strjonas/tischlein/out/actuators.png

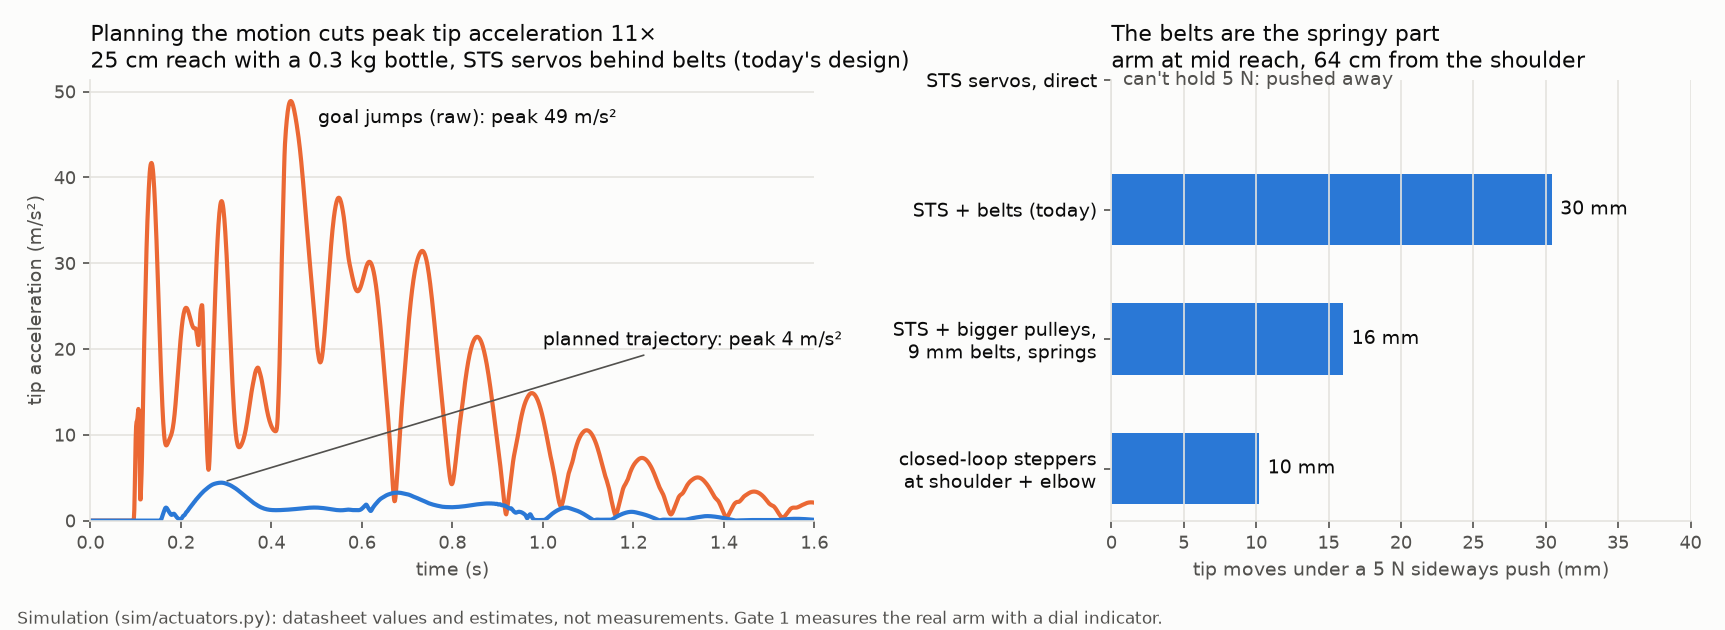
out/actuators.png
