strjonas/tischlein/out/demo_strip.png

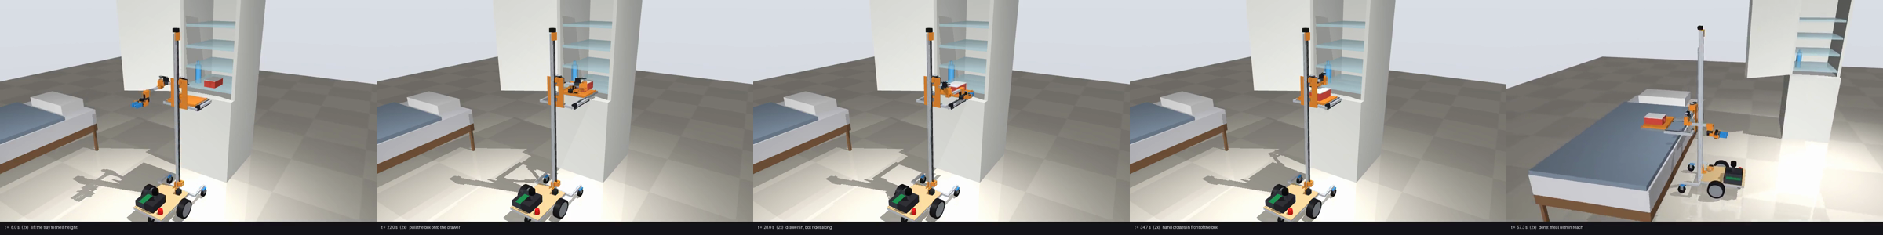
out/demo_strip.png
