strjonas/tischlein/out/heights.png

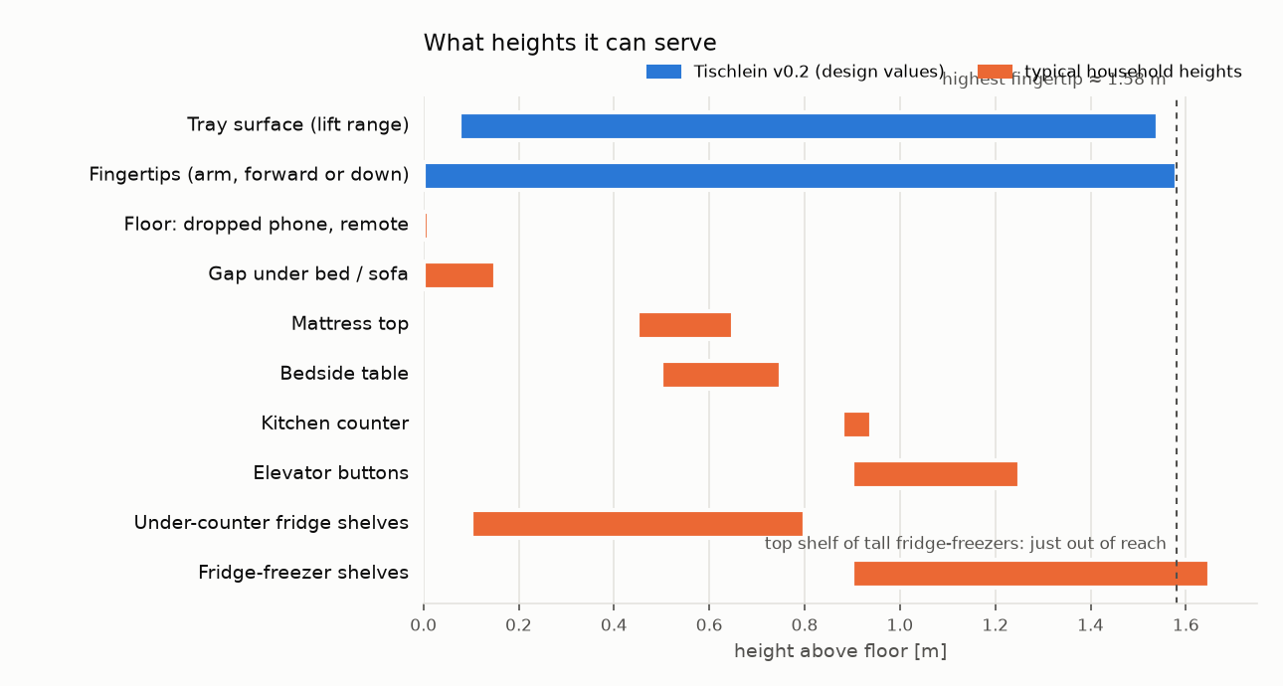
out/heights.png
