strjonas/tischlein/designs/breakfast-cell/build11/print/pin_microwave.stl

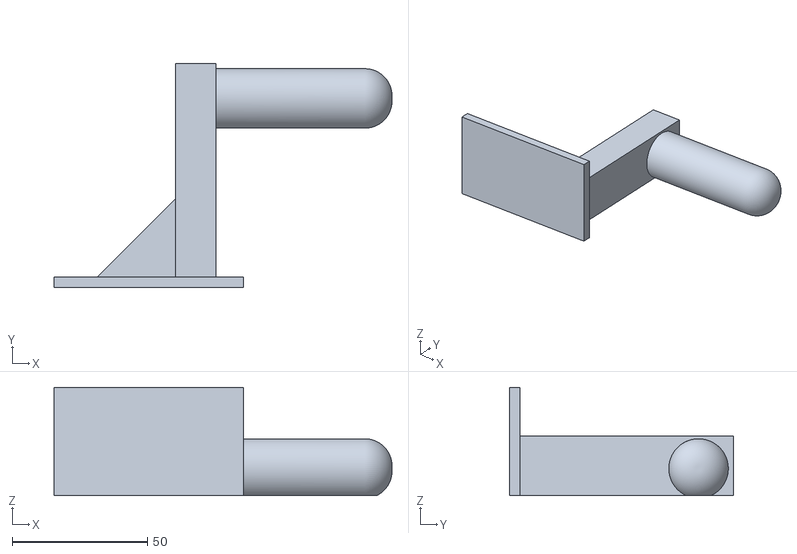
[picture p13: CAD file, 2026-11-09]
designs/breakfast-cell/build11/print/pin_microwave.stl
125.0 x 83.0 x 40.0
