strjonas/tischlein/out/tischlein_v0_2.step

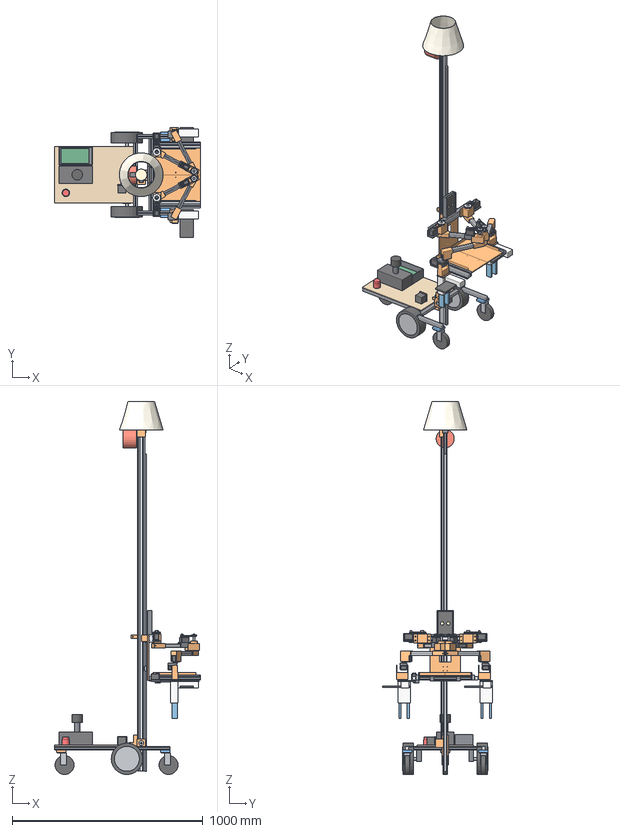
[picture p14: CAD file, 2026-11-09]
out/tischlein_v0_2.step
766.0 x 578.9 x 1954.6 mm
frame_side x 2
frame_cross
frame_cross_front
straddle_leg_2020 x 2
deck_plywood
hub_motor x 2
hub_motor_hub x 2
axle x 2
axle_clamp_adapter x 2
caster_wheel x 3
caster_fork x 3
front_caster_pad_tpu x 2
rear_caster_spring_mount
battery_hoverboard_36v
electronics_box
pi_and_drivers
estop
lidar_post
lidar_rplidar_c1
mast_2040
rail_mgn12
mast_foot_gusset x 2
nema17
nema17_mount
lift_pulley_20T
lift_reduction_60T
motor_pulley_20T
lift_lower_bearing_block
lift_top_idler
lift_top_block
lift_belt x 2
lamp_holder
lamp_led_disk
lamp_shade
balancer_hanger
spring_balancer_3_5kg
carriage_plate
mgn12h_block x 2
yoke_2020
tray_arm_2020 x 2
slide_250_outer x 2
slide_spacer x 2
yoke_bracket
servo_J5_roll x 10
pulley_20T_drawer
idler_drawer
belt_drawer
drawer_servo_mount
shoulder_beam_2040
shoulder_housing
bearing_6000 x 8
j1_servo_bracket
pulley_20T_J1 x 2
belt_J1_200 x 2
shoulder_housing_b
servo_J1
j1_servo_bracket_b
face_mount
face_phone
face_eye x 2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
