strjonas/tischlein/print/j1_servo_bracket_b.stl

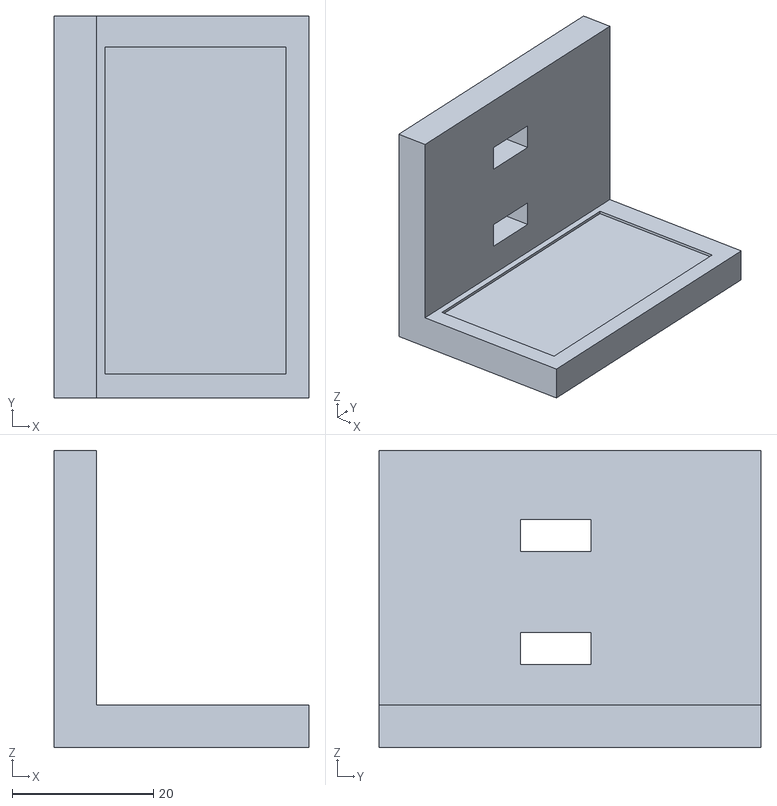
[picture p15: CAD file, 2026-11-09]
print/j1_servo_bracket_b.stl
36.0 x 54.0 x 42.0
