strjonas/tischlein/designs/breakfast-cell/build11/print/fit_gauge.stl

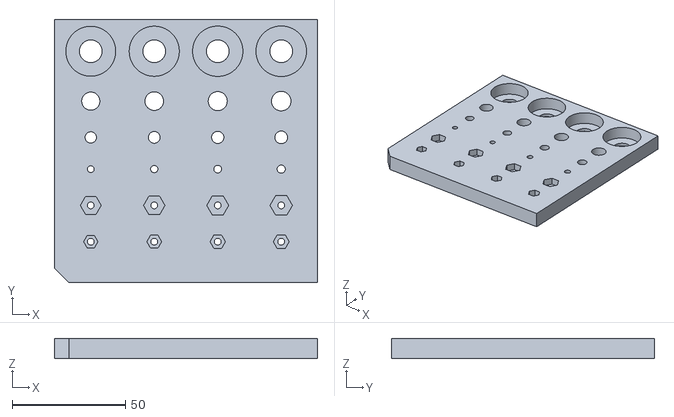
[picture p16: CAD file, 2026-11-09]
designs/breakfast-cell/build11/print/fit_gauge.stl
116.0 x 116.0 x 9.00
