strjonas/tischlein/designs/breakfast-cell/build11/print/slot_keys.stl

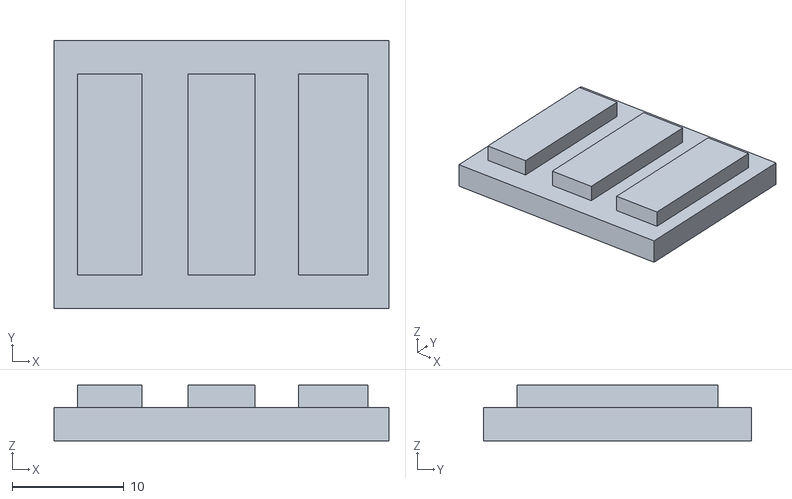
[picture p17: CAD file, 2026-11-09]
designs/breakfast-cell/build11/print/slot_keys.stl
30.0 x 24.0 x 5.00
