strjonas/tischlein/print/wrist_bracket.stl

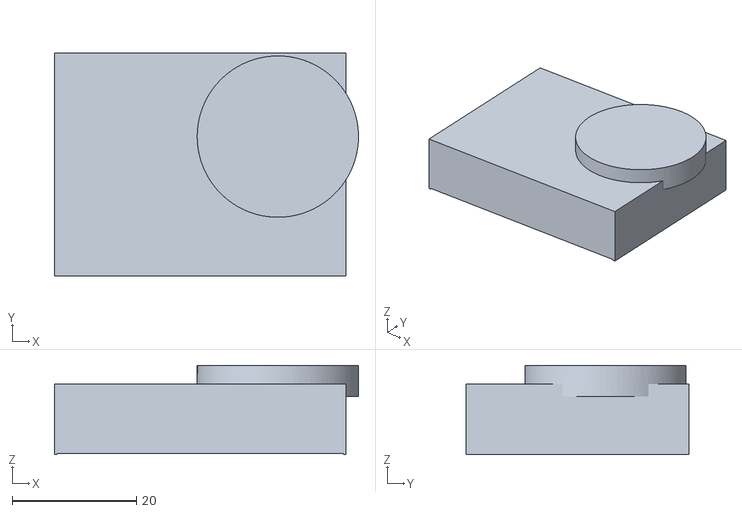
[picture p18: CAD file, 2026-11-09]
print/wrist_bracket.stl
49.0 x 36.0 x 14.4
