strjonas/tischlein/designs/breakfast-cell/build11/print/pin_fridge.stl

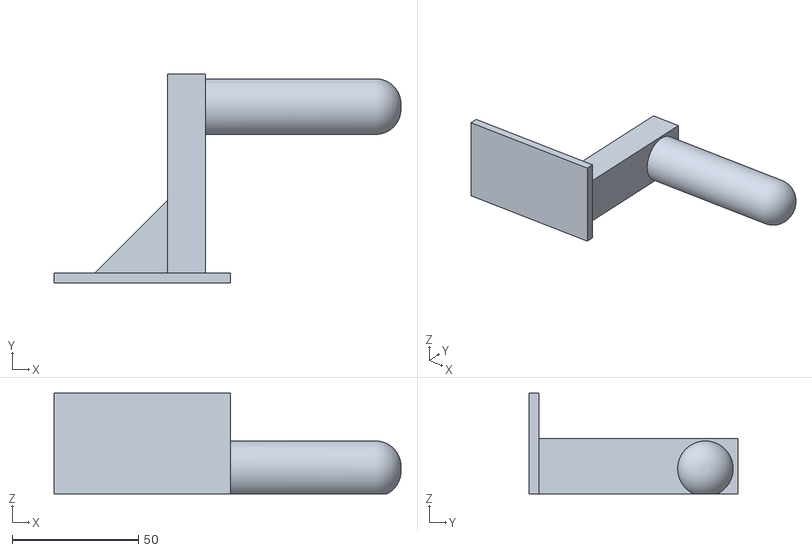
[picture p19: CAD file, 2026-11-09]
designs/breakfast-cell/build11/print/pin_fridge.stl
137.5 x 83.0 x 40.0
