strjonas/tischlein/print/l2_root_clamp.stl

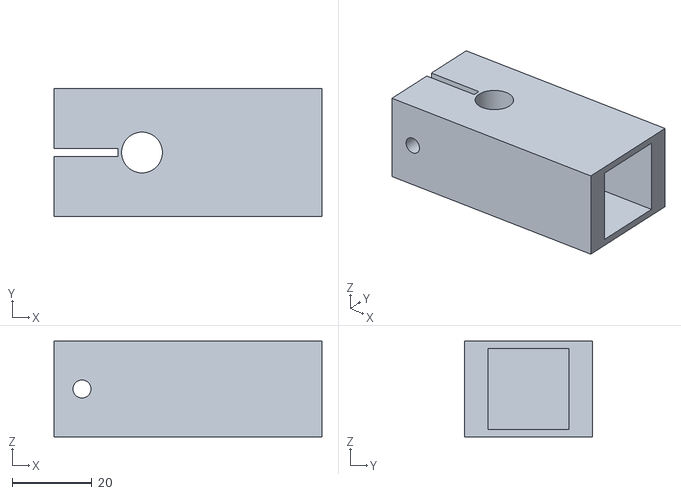
[picture p20: CAD file, 2026-11-09]
print/l2_root_clamp.stl
67.0 x 32.0 x 24.0
