strjonas/tischlein/designs/breakfast-cell/build11/print/servo_frames.stl

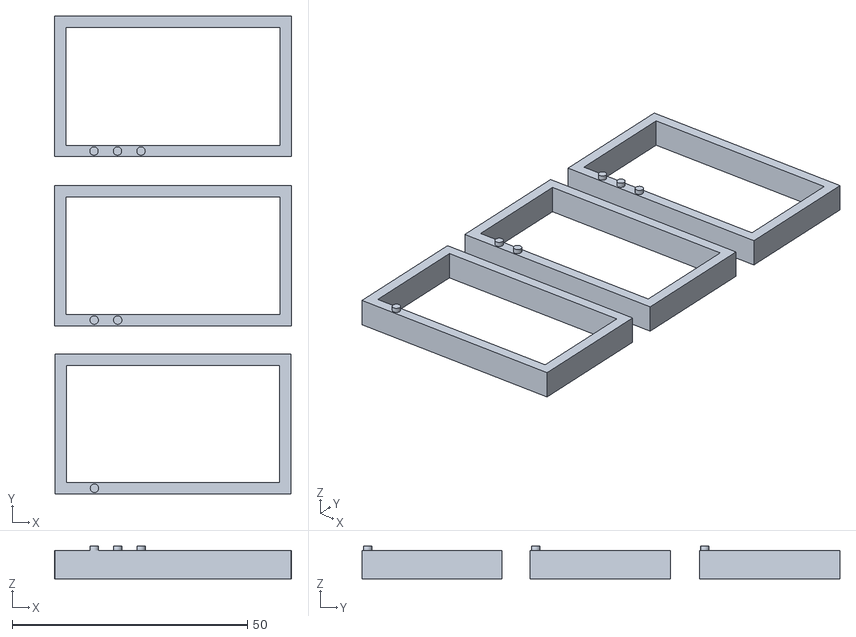
[picture p21: CAD file, 2026-11-09]
designs/breakfast-cell/build11/print/servo_frames.stl
50.4 x 101.6 x 7.00
