strjonas/tischlein/print/tray_belt_clamp.stl

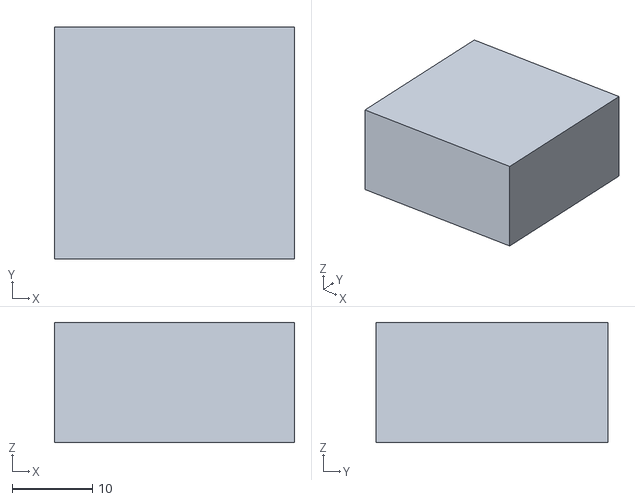
[picture p22: CAD file, 2026-11-09]
print/tray_belt_clamp.stl
30.0 x 29.0 x 15.0
