strjonas/tischlein/print/shoulder_housing.stl

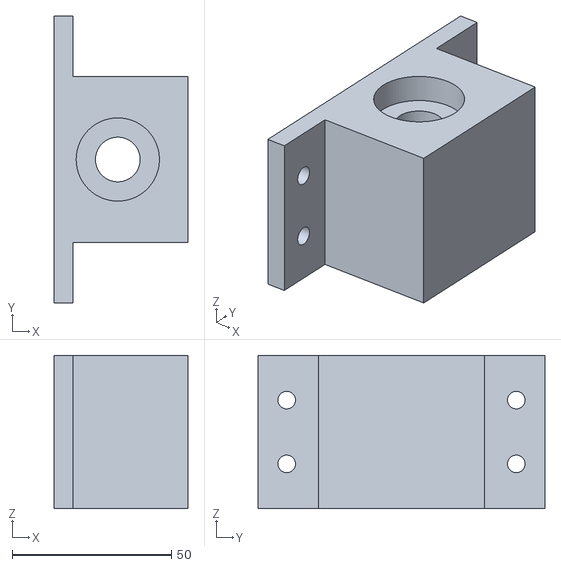
[picture p23: CAD file, 2026-11-09]
print/shoulder_housing.stl
42.0 x 90.0 x 48.0
