strjonas/tischlein/print/lamp_holder.stl

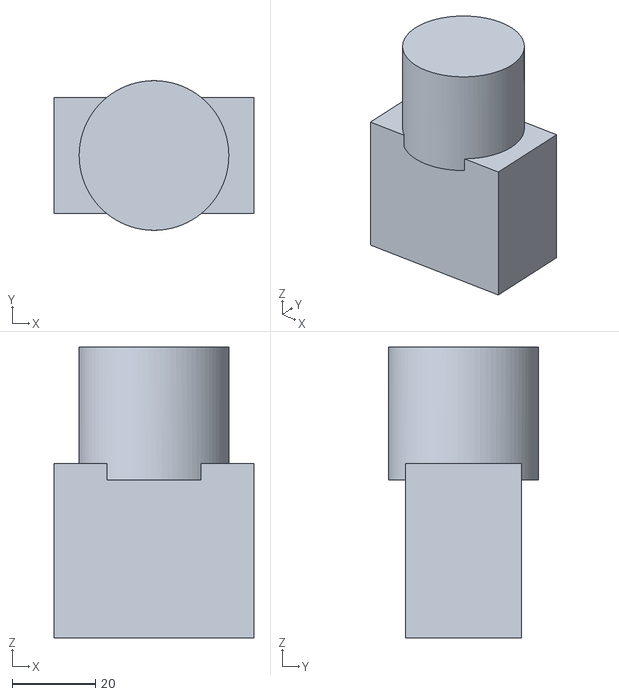
[picture p24: CAD file, 2026-11-09]
print/lamp_holder.stl
48.0 x 36.0 x 70.0
