strjonas/tischlein/print/axle_clamp_adapter.stl

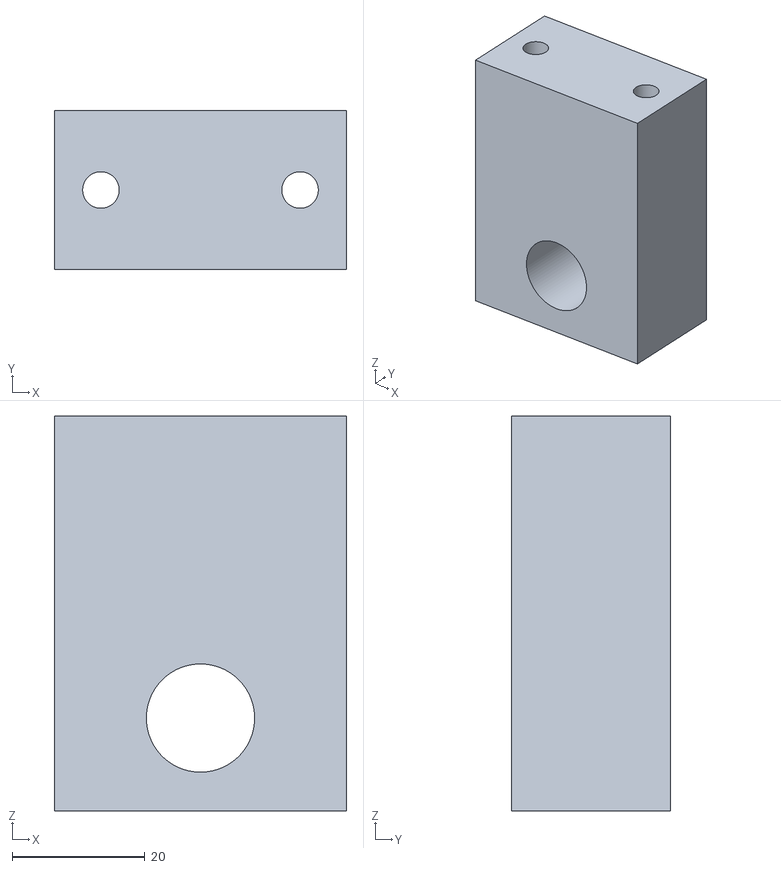
[picture p25: CAD file, 2026-11-09]
print/axle_clamp_adapter.stl
44.0 x 24.0 x 59.5
