strjonas/tischlein/print/lift_top_block.stl

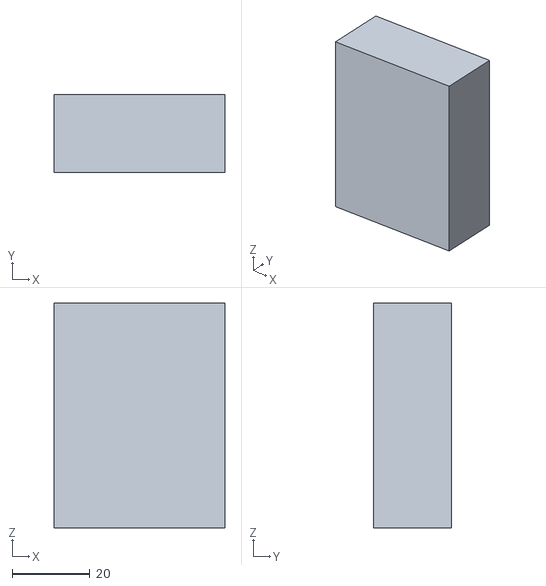
[picture p26: CAD file, 2026-11-09]
print/lift_top_block.stl
44.0 x 20.0 x 58.0
