strjonas/tischlein/print/tray_half_right.stl

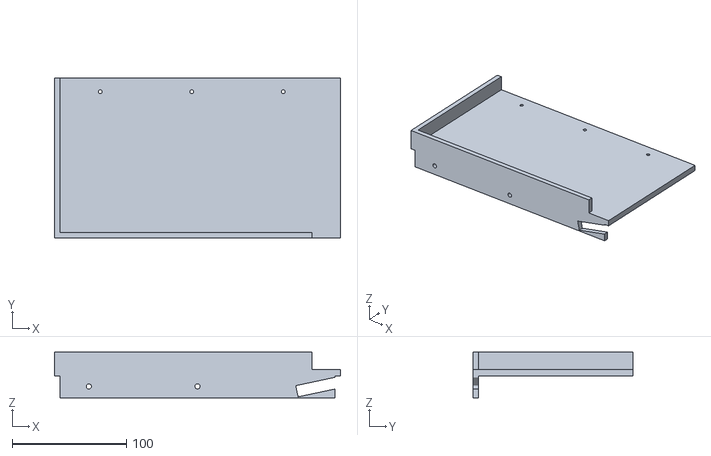
[picture p27: CAD file, 2026-11-09]
print/tray_half_right.stl
250.0 x 140.0 x 40.0
