strjonas/tischlein/print/rear_caster_spring_mount.stl

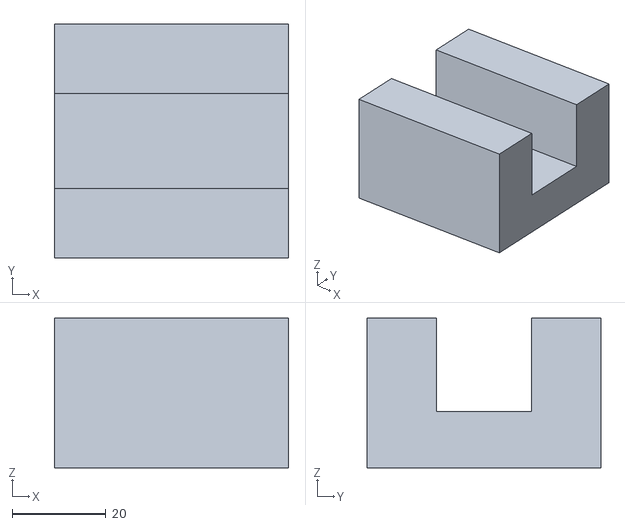
[picture p28: CAD file, 2026-11-09]
print/rear_caster_spring_mount.stl
50.0 x 50.0 x 32.0
