strjonas/tischlein/print/drawer_servo_mount.stl

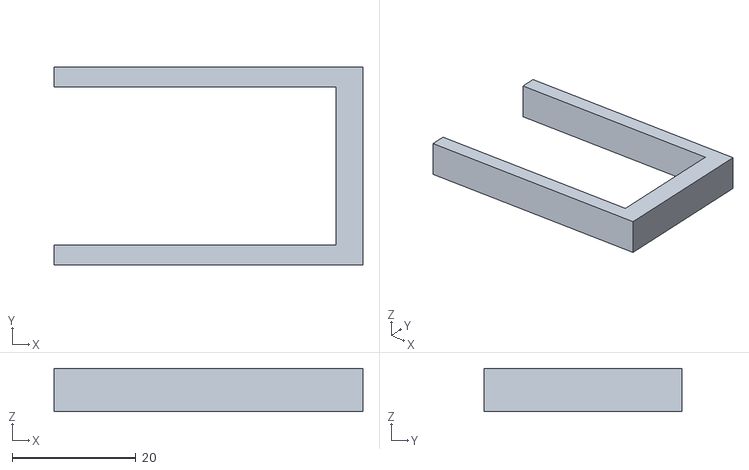
[picture p29: CAD file, 2026-11-09]
print/drawer_servo_mount.stl
50.0 x 32.0 x 7.00
