strjonas/tischlein/print/lift_lower_bearing_block.stl

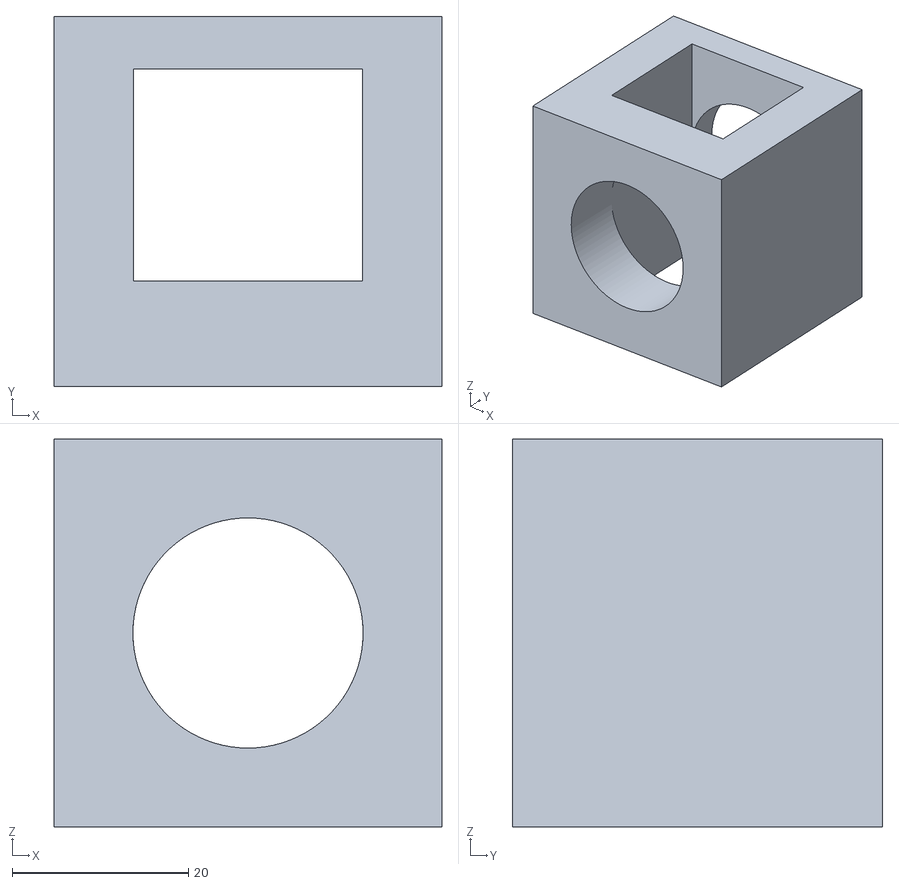
[picture p30: CAD file, 2026-11-09]
print/lift_lower_bearing_block.stl
44.0 x 42.0 x 44.0
