strjonas/tischlein/print/lidar_post.stl

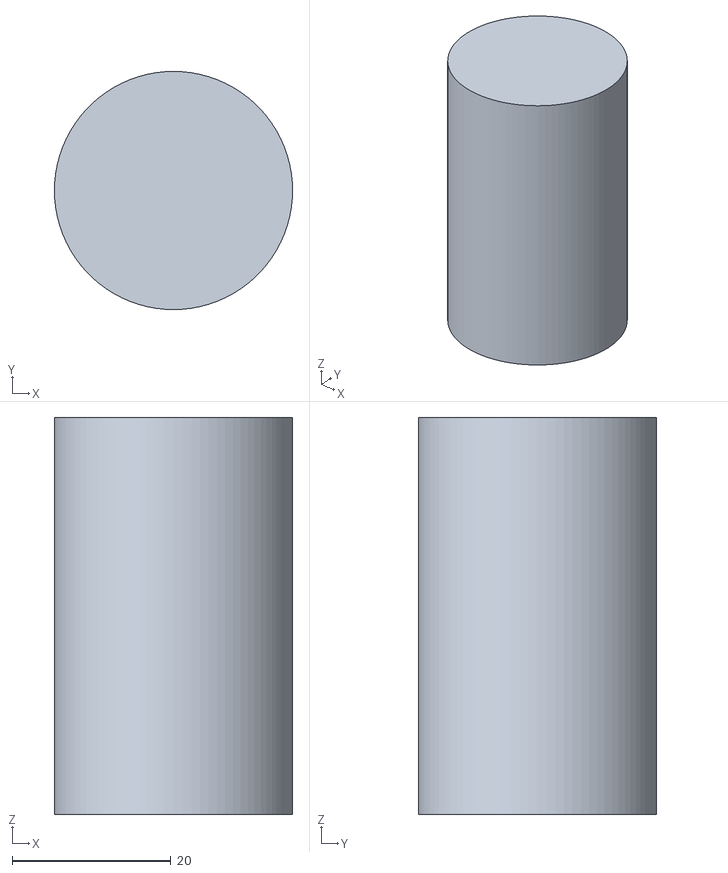
[picture p31: CAD file, 2026-11-09]
print/lidar_post.stl
30.0 x 30.0 x 50.0
