strjonas/tischlein/print/carriage_plate.stl

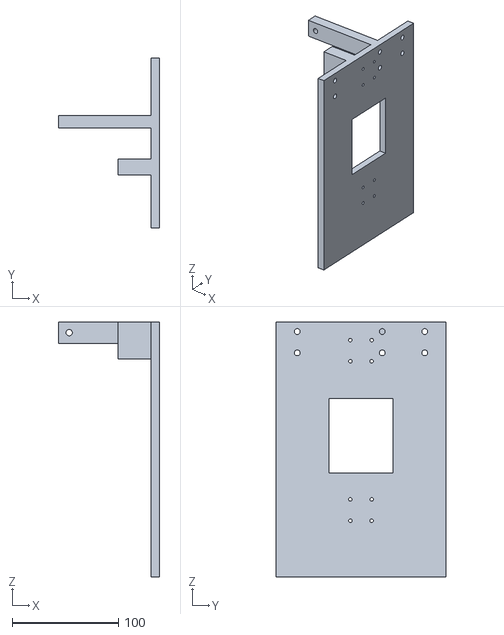
[picture p32: CAD file, 2026-11-09]
print/carriage_plate.stl
95.0 x 160.0 x 240.0
