strjonas/tischlein/print/roll_bracket.stl

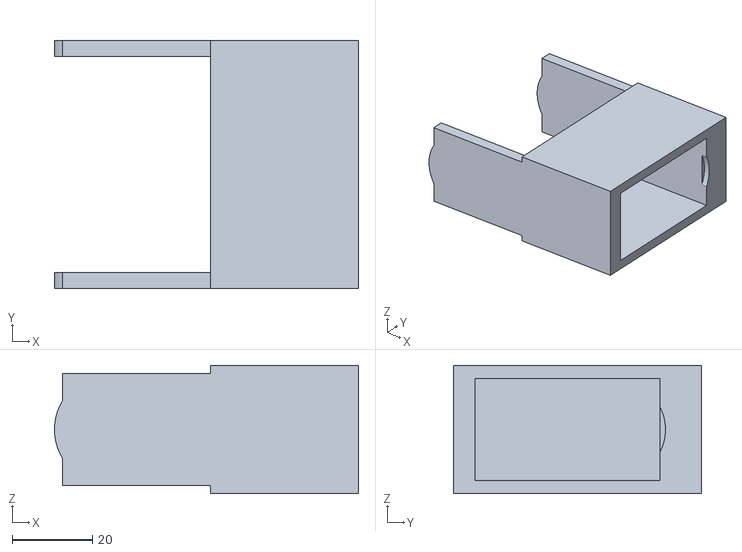
[picture p33: CAD file, 2026-11-09]
print/roll_bracket.stl
76.0 x 62.0 x 32.0
