strjonas/tischlein/print/balancer_hanger.stl

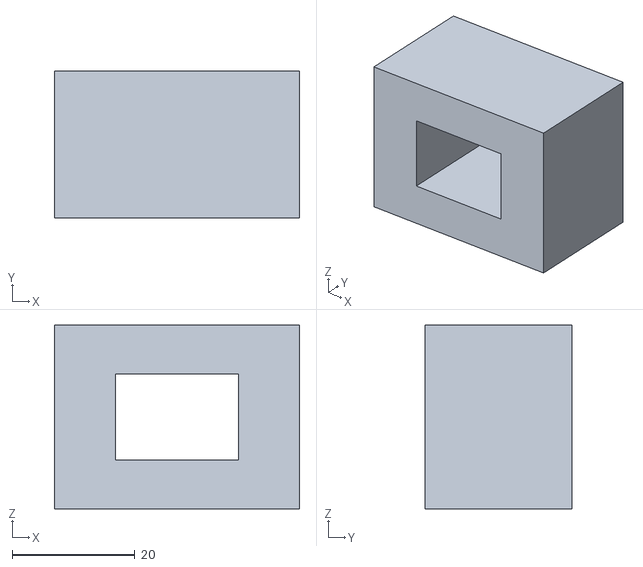
[picture p34: CAD file, 2026-11-09]
print/balancer_hanger.stl
40.0 x 24.0 x 30.0
