strjonas/tischlein/print/elbow_block.stl

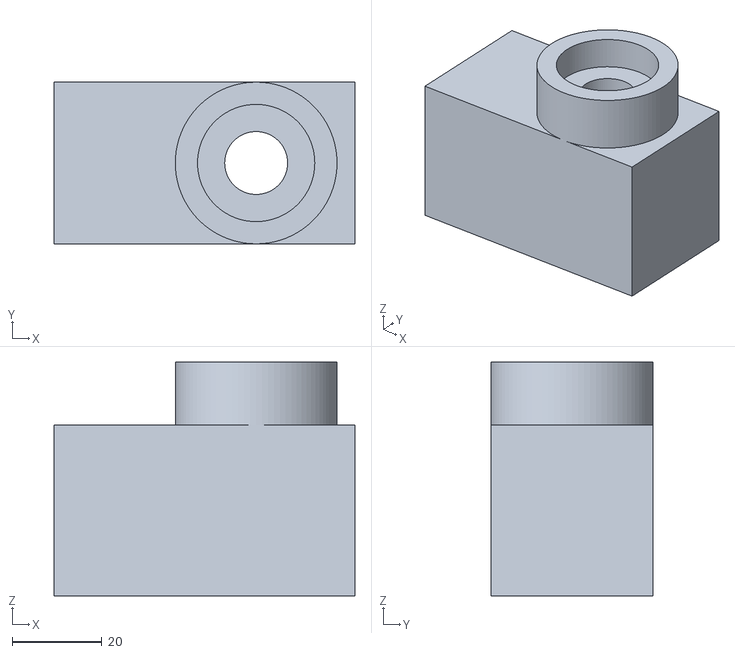
[picture p35: CAD file, 2026-11-09]
print/elbow_block.stl
67.0 x 36.0 x 52.0
