strjonas/tischlein/print/electronics_box.stl

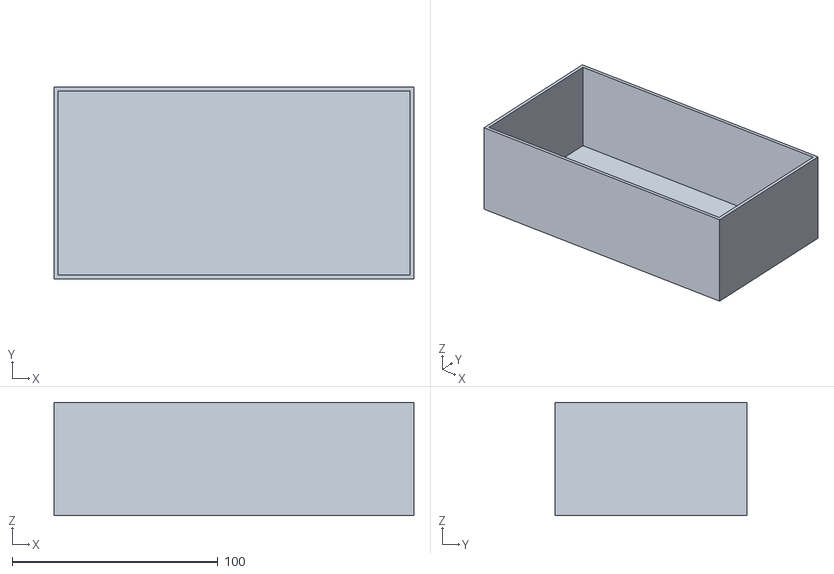
[picture p36: CAD file, 2026-11-09]
print/electronics_box.stl
175.0 x 93.5 x 55.0
