strjonas/tischlein/print/ir_cam_insert.stl

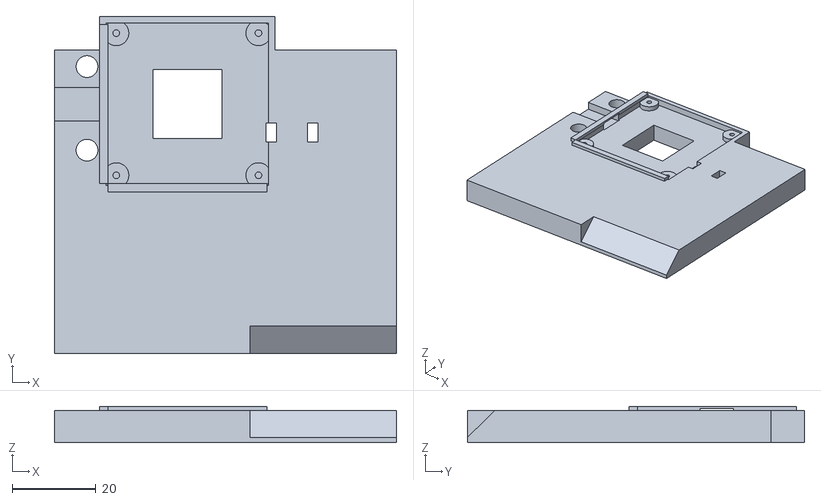
[picture p37: CAD file, 2026-11-09]
print/ir_cam_insert.stl
81.8 x 80.6 x 8.69
