strjonas/tischlein/print/slide_spacer.stl

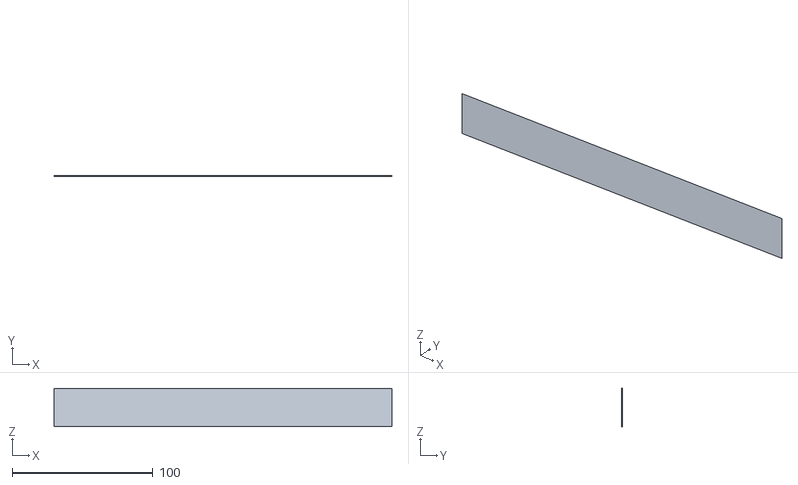
[picture p38: CAD file, 2026-11-09]
print/slide_spacer.stl
240.0 x 0.3 x 27.0
