strjonas/tischlein/print/nema17_mount.stl

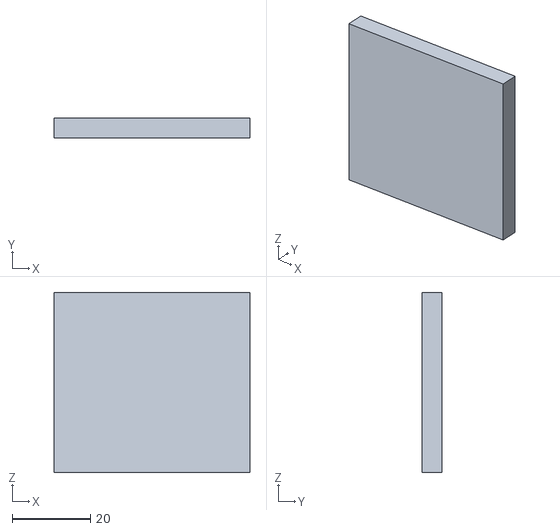
[picture p39: CAD file, 2026-11-09]
print/nema17_mount.stl
50.0 x 5.00 x 46.0
