strjonas/tischlein/print/front_caster_pad_tpu.stl

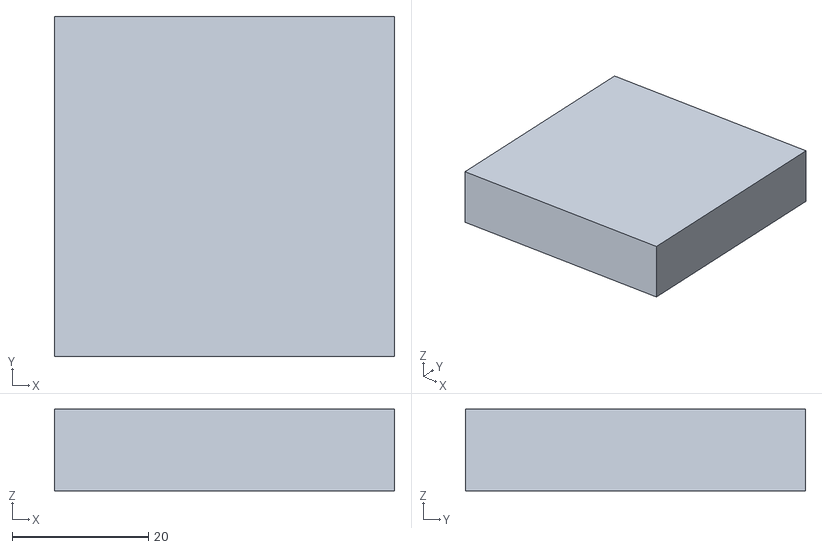
[picture p40: CAD file, 2026-11-09]
print/front_caster_pad_tpu.stl
50.0 x 50.0 x 12.0
