strjonas/tischlein/print/tray_seam_strap.stl

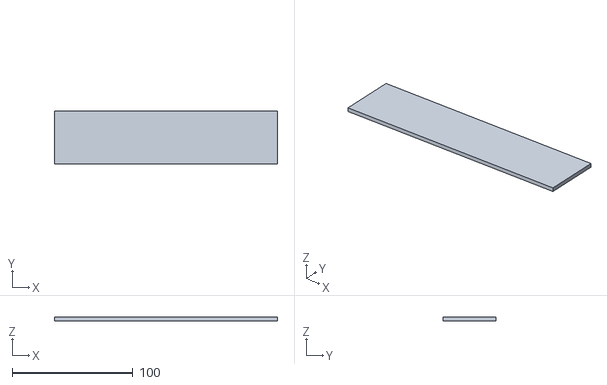
[picture p41: CAD file, 2026-11-09]
print/tray_seam_strap.stl
185.0 x 44.0 x 3.00
