strjonas/tischlein/print/mast_foot_gusset.stl

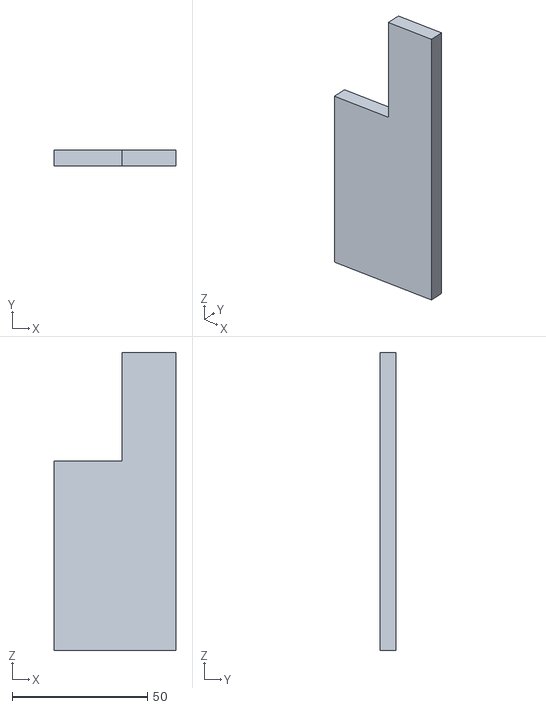
[picture p42: CAD file, 2026-11-09]
print/mast_foot_gusset.stl
45.0 x 6.00 x 110.0
