strjonas/tischlein/print/face_mount.stl

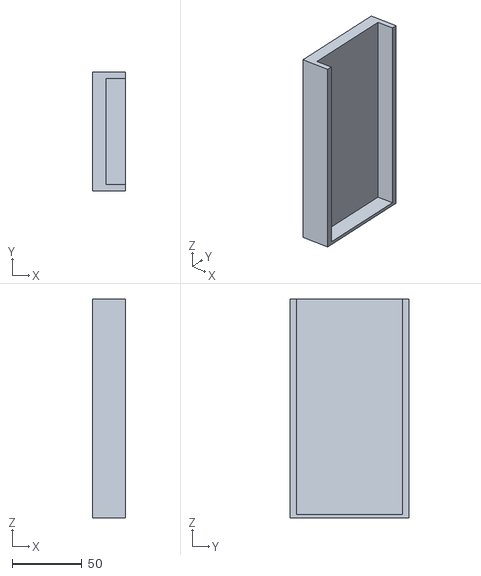
[picture p43: CAD file, 2026-11-09]
print/face_mount.stl
24.0 x 85.0 x 157.0
