strjonas/tischlein/print/j2_servo_saddle.stl

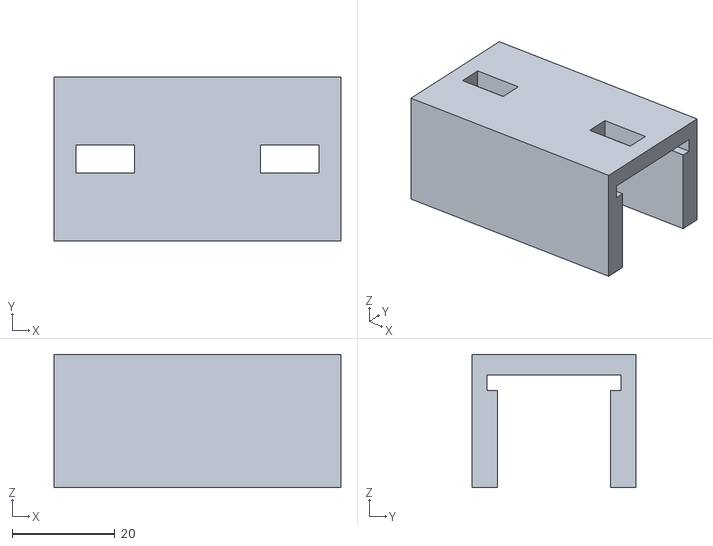
[picture p44: CAD file, 2026-11-09]
print/j2_servo_saddle.stl
56.0 x 32.0 x 26.0
