strjonas/tischlein/print/wrist_block.stl

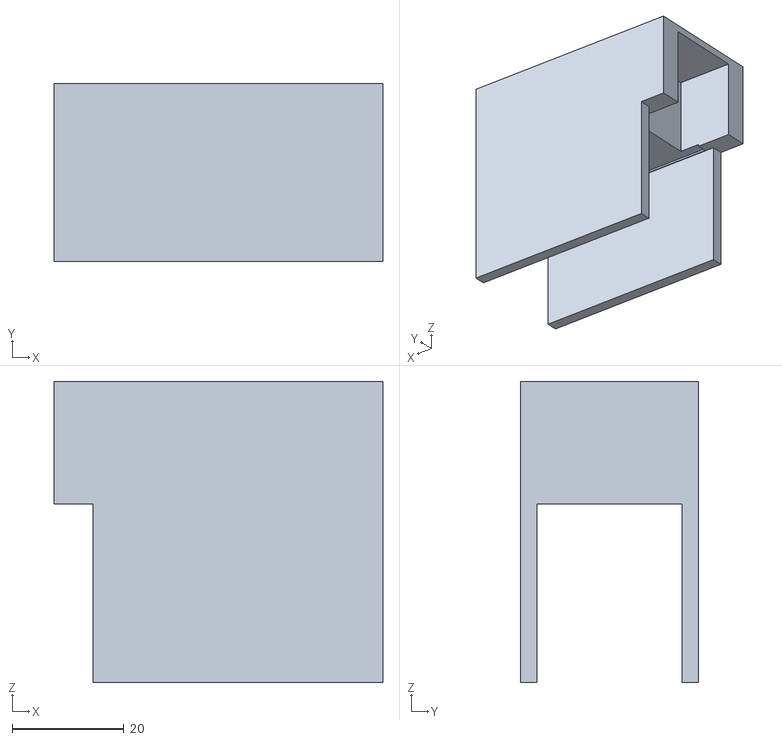
[picture p45: CAD file, 2026-11-09]
print/wrist_block.stl
59.0 x 32.0 x 54.0
