strjonas/tischlein/print/yoke_bracket.stl

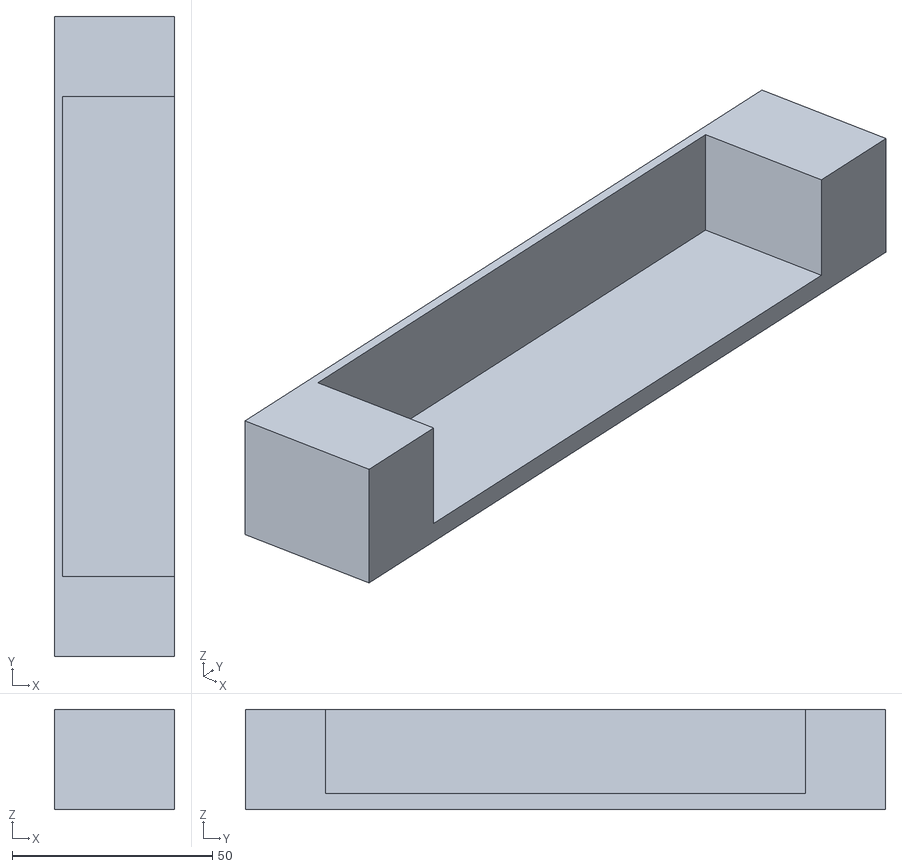
[picture p46: CAD file, 2026-11-09]
print/yoke_bracket.stl
30.0 x 160.0 x 25.0
