strjonas/tischlein/print/cap_adapter_plate.stl

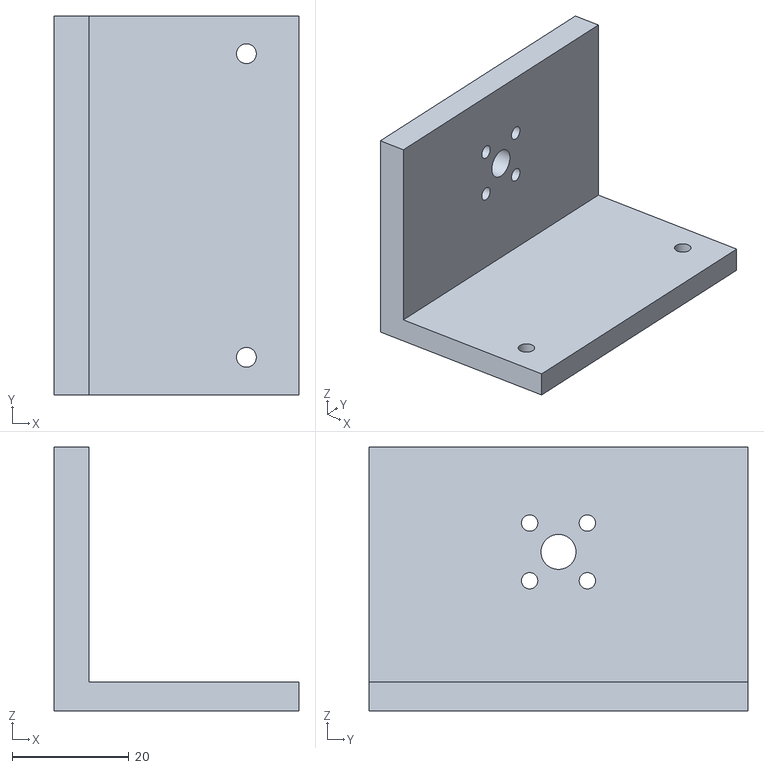
[picture p47: CAD file, 2026-11-09]
print/cap_adapter_plate.stl
42.0 x 65.0 x 45.3
