strjonas/tischlein/(list of files, cad)

Other CAD files:
print/j1_servo_bracket.stl
print/tray_half_left.stl
print/shoulder_housing_b.stl
