strjonas/tischlein/designs/breakfast-cell/build11/viewer.html

# Build11 breakfast cell

Planned and physics mornings

Jar 1 L box

90 cm fridge 50 cm fridge

Plan Physics

See-through appliances

×

Drag to turn · scroll to zoom · click a part

Morning Parts Checks

▶ 0:00

Speed

1×4×10×

Parts list of the build11 cell. The wrist yaw is an STS3250, because the physics showed the stock servo breaking fridge seals only up to about 17 N. The hand, pins and rails are printed in PETG. The box job's two lines are for 1 L glass boxes. Click a line to light up its parts.
