strjonas/tischlein/designs/breakfast-cell/build11/print/preview.png

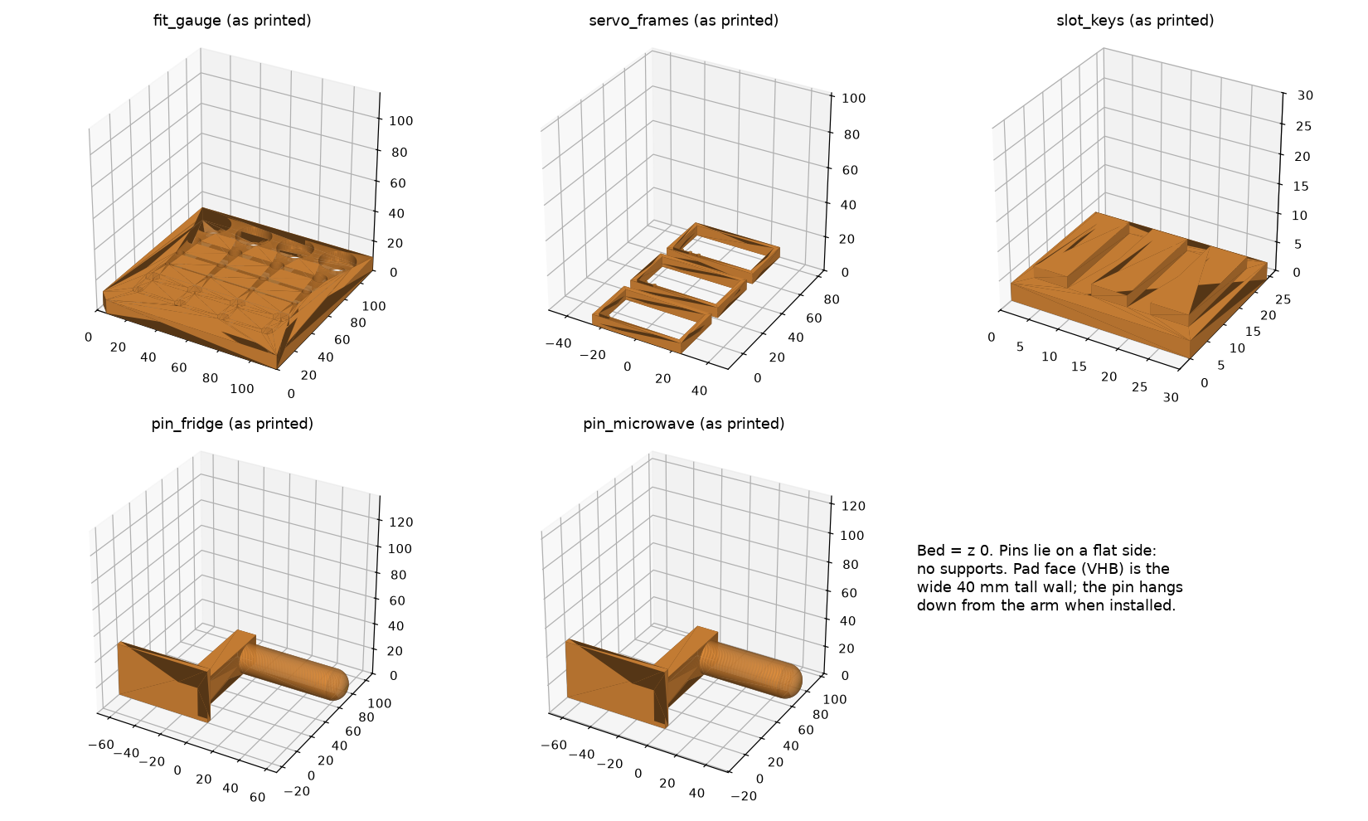
designs/breakfast-cell/build11/print/preview.png
